goldenfaeron/MotorDocu/(list of files, cad)

Other CAD files:
motor_L/cad/step/actuatorLAssembly.step
motor_L/cad/step/BLDC/BLDCAssembly.step
motor_L/cad/step/drive/driveAssembly.step
motor_M/cad/step/actuatorMAssembly.step
motor_S/cad/step/actuatorSAssembly.step
motor_M/cad/step/drive/driveAssembly.step
motor_S/cad/step/BLDC/BLDCAssembly.step
motor_M/cad/step/BLDC/BLDCAssembly.step
motor_S/cad/step/drive/driveAssembly.step
assembly/Actuators.step
motor_M/cad/step/BLDC/magnetRing.step
motor_M/cad/step/drive/inputShaft.step
motor_M/cad/step/springContactBracket.step
motor_S/cad/step/BLDC/stator.step
motor_S/cad/step/springContactBracketFDM.step
motor_L/cad/step/BLDC/Same_Sky_CUI_DEVICES_AMT102-2048-I6000-S_a.step
motor_L/cad/step/drive/driveShell.step
motor_L/cad/step/springContactBracket.step
motor_M/cad/step/BLDC/Rotor.step
motor_M/cad/step/drive/cycloidalDisk_20.step
motor_S/cad/step/BLDC/3mmShaftAdapter.step
motor_S/cad/step/drive/upperOutputShaft.step
motor_L/cad/step/BLDC/magnetRing.step
motor_L/cad/step/drive/driveTopCover.step
motor_M/cad/step/BLDC/Shell.step
motor_M/cad/step/drive/driveShell.step
motor_M/cad/step/springContactBracketFMD.step
motor_S/cad/step/BLDC/encoderMountingPlate.step
motor_S/cad/step/drive/18x5Magnet.step
motor_S/cad/step/springContactBracket.step
motor_L/cad/step/BLDC/encoderMountingPlate.step
motor_M/cad/step/BLDC/t25EncoderCoupler.step
motor_M/cad/step/drive/40x25x5Magnet.step
motor_S/cad/step/BLDC/Shell.step
motor_L/cad/step/BLDC/bearingSpacer.step
motor_L/cad/step/drive/inputShaft.step
motor_M/cad/step/BLDC/t25Gear.step
motor_S/cad/step/BLDC/Rotor.step
motor_S/cad/step/drive/lowerOutputShaft.step
motor_L/cad/step/BLDC/t50Gear_a.step
motor_L/cad/step/drive/stapleSpacer.step
motor_M/cad/step/BLDC/t50Gear_a.step
motor_S/cad/step/drive/driveShell.step
motor_L/cad/step/BLDC/stator.step
motor_L/cad/step/drive/cycloidalDisk.step
motor_M/cad/step/BLDC/3mmShaftAdapter.step
motor_M/cad/step/drive/stapleSpacer.step
motor_S/cad/step/BLDC/magnetRing.step
motor_S/cad/step/drive/driveTopCover.step
motor_L/cad/step/BLDC/t25EncoderCoupler.step
motor_L/cad/step/drive/40x25x5Magnet.step
motor_M/cad/step/drive/cycloidalDisk_M_6mmPins.step
motor_S/cad/step/drive/stapleSpacer.step
motor_L/cad/step/BLDC/Shell.step
motor_L/cad/step/drive/upperOutputShaft.step
motor_M/cad/step/BLDC/encoderMountingPlate.step
motor_M/cad/step/drive/cycloidalDisk_19.step
motor_S/cad/step/drive/cycloidalDisk_S_6und4mmPins.step
motor_L/cad/step/BLDC/Shell_Updated.step
motor_M/cad/step/BLDC/stator.step
motor_M/cad/step/drive/driveTopCover.step
motor_S/cad/step/drive/cycloidalDisk.step
motor_L/cad/step/BLDC/Rotor.step
motor_L/cad/step/drive/lowerOutputShaft.step
motor_M/cad/step/drive/lowerOutputShaft.step
motor_S/cad/step/drive/inputShaft.step
motor_M/cad/step/drive/upperOutputShaft.step
motor_L/cad/BLDC/Rotor.3mf
motor_L/cad/BLDC/Shell.3mf
motor_L/cad/BLDC/encoderMountingPlate.3mf
motor_L/cad/BLDC/t25EncoderCoupler.3mf
motor_L/cad/BLDC/t50Gear_a.3mf
motor_L/cad/drive/driveShell.3mf
motor_L/cad/drive/driveTopCover.3mf
motor_L/cad/drive/inputShaft.3mf
motor_L/cad/drive/lowerOutputShaft.3mf
motor_L/cad/drive/stapleSpacer.3mf
motor_L/cad/drive/upperOutputShaft.3mf
motor_L/cad/springContactBracket.3mf
motor_L/cad/step/drive/M8x10x20 Bushing.step
motor_L/cad/step/drive/M8x10x25 Bushing.step
motor_M/cad/BLDC/Rotor.3mf
motor_M/cad/BLDC/Shell.3mf
motor_M/cad/BLDC/encoderMountingPlate.3mf
motor_M/cad/BLDC/t25EncoderCoupler.3mf
motor_M/cad/BLDC/t50Gear_a.3mf
motor_M/cad/drive/driveShell.3mf
motor_M/cad/drive/driveTopCover.3mf
motor_M/cad/drive/inputShaft.3mf
motor_M/cad/drive/lowerOutputShaft.3mf
motor_M/cad/drive/stapleSpacer.3mf
motor_M/cad/drive/upperOutputShaft.3mf
motor_M/cad/springContactBracket.3mf
motor_M/cad/step/drive/M6x8x10 Bushing.step
motor_M/cad/step/drive/M6x8x20 Bushing.step
motor_S/cad/BLDC/3mmShaftAdapter.3mf
motor_S/cad/BLDC/Rotor.3mf
motor_S/cad/BLDC/Shell.3mf
motor_S/cad/BLDC/encoderMountingPlate.3mf
motor_S/cad/drive/driveShell.3mf
motor_S/cad/drive/driveTopCover.3mf
motor_S/cad/drive/inputShaft.3mf
motor_S/cad/drive/lowerOutputShaft.3mf
motor_S/cad/drive/stapleSpacer.3mf
motor_S/cad/drive/upperOutputShaft.3mf
motor_S/cad/springContactBracket.3mf
motor_S/cad/step/drive/M4x6x10 Bushing.step
motor_S/cad/step/drive/M6x8x20 Bushing.step
