goldenfaeron/MotorDocu/(commit log)

2026-11-12 Create standalone motors repo with CAD and plain-Markdown docs
    Combines motor_L, motor_M, and motor_S CAD plus their documentation
    (converted out of the Obsidian vault into plain Markdown/CommonMark,
    no Obsidian-specific syntax) into one self-contained repository.
    Motor L's cycloidal reduction is updated from 20:1 to 19:1 (Nl 20->19,
    Np 21->20, disk profile formula updated accordingly).
    [3mmShaftAdapter.3mf, Motor_L_BOM.csv, Motor_M_BOM.csv, Motor_S_BOM.csv, Rotor.3mf, Shell.3mf, driveShell.3mf, driveTopCover.3mf]
2026-11-12 Run cycloidal disk analysis for Motor L's 19:1 geometry
    Adds scripts/cycloidal_disk_analysis.py (parametrized for Motor L)
    and recomputes Motor L's derived parameters for Nl=19/Np=20, Rr=4mm.
    Pressure angle (alpha_min/alpha_avg) is carried forward from the old
    20:1 run, not re-measured: the mevirtuoso.com pressure-angle
    simulator linked in the original docs is a paid Premium feature, not
    freely accessible, so it wasn't used.
    Flags the real finding: dropping one lobe reduces effective engaged
    pins (5.25->5.0), raising max ring-pin force ~5% and pushing the
    already-marginal PA6 disk's Hertz pressure check to FAIL. Validation
    checklist unchecked pending re-verification.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
2026-11-12 Separate ring and output pin Hertz checks for Motor L
    The analysis script previously computed "p_out_max" by reusing the
    ring pin's own force with a different radius formula -- it never
    actually modeled the output pin's own force or geometry. Split it
    into two real, independent convex-concave contacts: ring pin vs.
    disk hole (Rr=5mm, Fp,max) and output pin vs. its own disk hole
    (Rr,out=4mm, Fout,max), both using the same pin-in-oversized-hole
    mechanism tied to eccentricity e.
    Net result at these radii: ring pin governs, Cast PA6 (dry) is
    MARGINAL (75.3 vs 65 MPa), in the same ballpark as the original 20:1
    design's margin (71.0 MPa) rather than meaningfully worse. Added a
    steel-disk comparis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
2026-11-13 Sort full-project Fusion export down to motor-relevant CAD only
    The latest Fusion mass-export covered the whole "StuR" project, not
    just the motors: a PrintNC CNC router, a torque test rig, a CNC-shop
    request folder, and loose encoder/electronics STEP duplicates came
    along with the three actuators. Keep only what's actually part of
    the motors:
    - motor_L/M/S/cad/step/ — new parametric STEP export per motor
    (assembly, BLDC, drive), alongside the existing 3MF meshes
    - assembly/Actuators.step — combined STEP of all three actuators
    Dropped: PrintNC, torque test rig + test files, the CNC_Anfrage
    machined-part exports, loose top-level hall_encoder/Same_Sky
    duplicates (electronics already ha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
    [18x5Magnet.step, 3mmShaftAdapter.step, 40x25x5Magnet.step, Actuators.step, BLDCAssembly.step, M4x6x10 Bushing.step, M6x8x10 Bushing.step, M6x8x20 Bushing.step]
